doyounyu/T-motor-Light-F4/image-20221222220833677.png

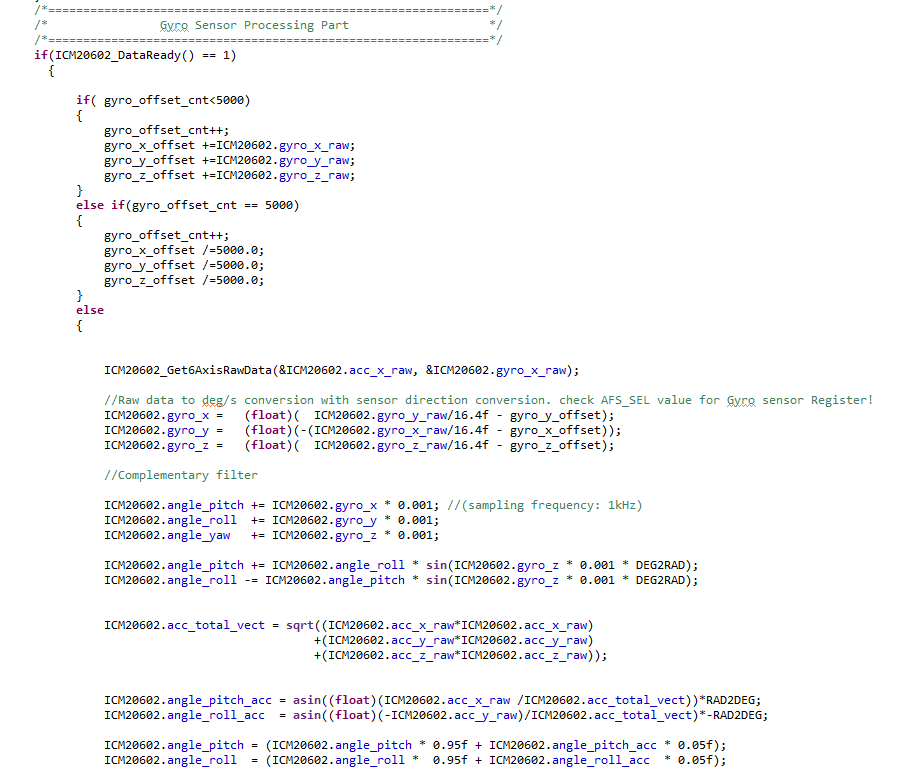
image-20221222220833677.png
