doyounyu/T-motor-Light-F4/KakaoTalk_20221223_194000058.jpg

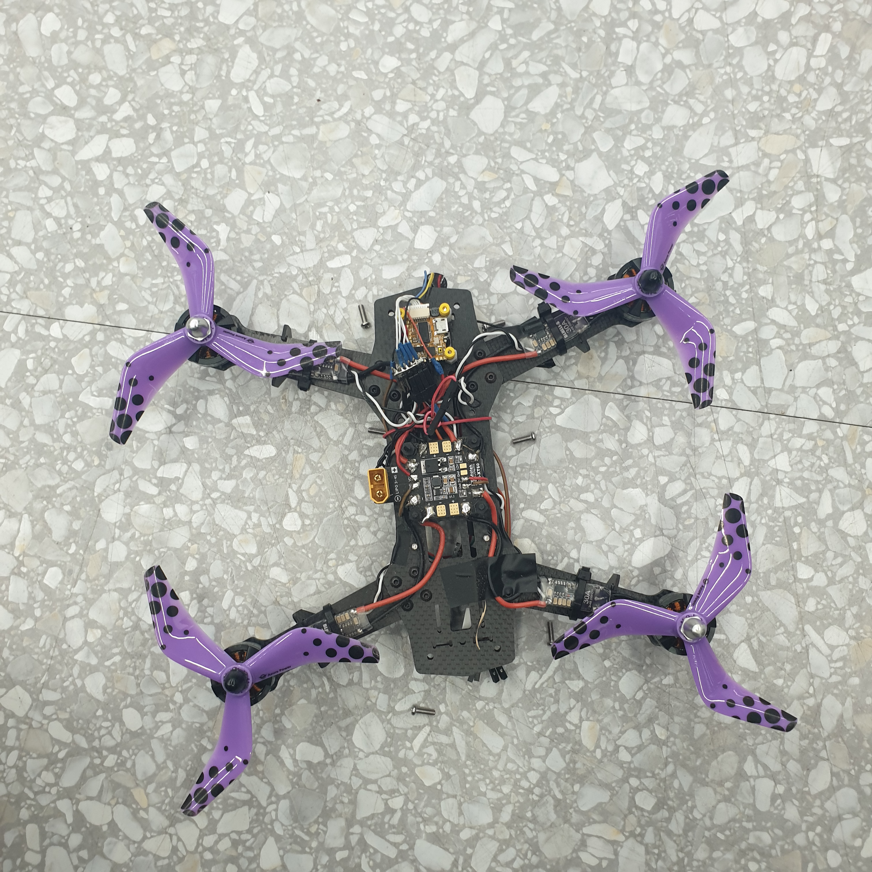
KakaoTalk_20221223_194000058.jpg
