doyounyu/T-motor-Light-F4/Core/Inc/main.h

#define GYRO_INT_Pin LL_GPIO_PIN_1
#define GYRO_INT_GPIO_Port GPIOA
#define BLUETOOTH_TX_Pin LL_GPIO_PIN_2
#define BLUETOOTH_TX_GPIO_Port GPIOA
#define BLUETOOTH_RX_Pin LL_GPIO_PIN_3
#define BLUETOOTH_RX_GPIO_Port GPIOA
#define GYRO_CS_Pin LL_GPIO_PIN_4
#define GYRO_CS_GPIO_Port GPIOA
#define GYRO_SCK_Pin LL_GPIO_PIN_5
#define GYRO_SCK_GPIO_Port GPIOA
#define GYRO_MISO_Pin LL_GPIO_PIN_6
#define GYRO_MISO_GPIO_Port GPIOA
#define GYRO_MOSI_Pin LL_GPIO_PIN_7
#define GYRO_MOSI_GPIO_Port GPIOA
#define LEDpin_Pin LL_GPIO_PIN_8
#define LEDpin_GPIO_Port GPIOA
#define SUMD_TX_Pin LL_GPIO_PIN_9
#define SUMD_TX_GPIO_Port GPIOA
#define SUMD_RX_Pin LL_GPIO_PIN_10
#define SUMD_RX_GPIO_Port GPIOA
