doyounyu/T-motor-Light-F4/Core/Inc/ecPWM.h

/**
******************************************************************************
* @author  SSSLAB
* @Mod		 2021-8-12 by YKKIM  	
* @brief   Embedded Controller:  EC_HAL_for_student_exercise 
* 
******************************************************************************
*/

#include "stm32f411xe.h"
#include "ecGPIO.h"
#include "ecTIM.h"  			// change to ecTIM.h

#ifndef __EC_PWM_H
#define __EC_PWM_H

#ifdef __cplusplus
 extern "C" {
#endif /* __cplusplus */

typedef struct{
   GPIO_TypeDef *port;
   int pin;
   TIM_TypeDef *timer;
   int ch;
} PWM_t;


/* PWM Configuration */
void PWM_init(PWM_t *pwm, GPIO_TypeDef *port, int pin);
void PWM_2kHz_init(PWM_t *pwm, GPIO_TypeDef *port, int pin);
void PWM_period_ms(PWM_t *pwm,  uint32_t msec);
void PWM_period_us(PWM_t *PWM_pin, uint32_t usec); 
void PWM_2kHz(PWM_t *pwm);

void PWM_pulsewidth_ms(PWM_t *pwm, float pulse_width_ms);
void PWM_pulsewidth_us(PWM_t *pwm, float pulse_width_ms);
void PWM_2kHz_pulsewidth_us(PWM_t *pwm, float pulse_width_us);
void PWM_duty(PWM_t *pwm, float duty);
void PWM_pinmap(PWM_t *PWM_pin);



#ifdef __cplusplus
}
#endif /* __cplusplus */

#endif
